badramattack/spd-programmer/kicad/spd-programmer-jlcpcb-bom.csv

Comment | Designator | Footprint | JLCPCB Part #
1uF | C1,C2,C3,C4,C5,C6 | Capacitor_SMD:C_0603_1608Metric | C15849
100nF | C7 | Capacitor_SMD:C_0603_1608Metric | C14663
10uF 25V | C8,C9,C10,C11 | Capacitor_SMD:C_0805_2012Metric | C15850
SS14 | D1 | Diode_SMD:D_SMA | C2480
Red LED 0805 | D2,D6 | LED_SMD:LED_0805_2012Metric | C84256
Green LED 0805 | D3,D7,D8,D9,D10 | LED_SMD:LED_0805_2012Metric | C2297
Yellow LED 0805 | D4,D5 | LED_SMD:LED_0805_2012Metric | C2296
AO3400A | Q1 | Package_TO_SOT_SMD:SOT-23 | C20917
150k | R1 | Resistor_SMD:R_0603_1608Metric | C22807
2.2k | R2,R5 | Resistor_SMD:R_0603_1608Metric | C4190
100k | R3,R6,R8,R9 | Resistor_SMD:R_0603_1608Metric | C25803
220k | R4 | Resistor_SMD:R_0603_1608Metric | C22961
10k | R7,R14,R19,R21,R23,R24,R25,R27 | Resistor_SMD:R_0603_1608Metric | C25804
47 | R10 | Resistor_SMD:R_0805_2012Metric | C17714
4.7k | R11,R12,R13,R16 | Resistor_SMD:R_0603_1608Metric | C23162
10 | R15 | Resistor_SMD:R_0603_1608Metric | C22859
1.2k | R17 | Resistor_SMD:R_0603_1608Metric | C22765
1k | R18,R26 | Resistor_SMD:R_0603_1608Metric | C21190
150 | R20 | Resistor_SMD:R_0603_1608Metric | C22808
3.3k | R22 | Resistor_SMD:R_0603_1608Metric | C22978
220 | R28 | Resistor_SMD:R_0603_1608Metric | C22962
2.7k | R32,R33,R34,R35 | Resistor_SMD:R_0603_1608Metric | C13167
680 | R29,R30,R31 | Resistor_SMD:R_0603_1608Metric | C23228
MST-22D18G2-3J SPDT slide switch | SW1,SW4 | spd:SW_SPDT_CK_JS102011SAQN_SCQN_ShouHan_MST-22D18G2 | C2875122
TS-1187A tactile switch | SW2,SW3 | Button_Switch_SMD:SW_Push_1P1T_XKB_TS-1187A | C318884
TPS2553DBVR | U1,U2 | Package_TO_SOT_SMD:SOT-23-6 | C55266
XC6206P252MR | U3 | Package_TO_SOT_SMD:SOT-23-3 | C15906
SN74LVC2G66DCUR | U4 | Package_SO:VSSOP-8_2.3x2mm_P0.5mm | C181970
LM2665M6X/NOPB | U5 | Package_TO_SOT_SMD:SOT-23-6 | C201725
LP2951ACDR2G | U6 | Package_SO:SOIC-8_3.9x4.9mm_P1.27mm | C232432
