badramattack/spd-programmer/kicad/spd-programmer-schematic.pdf

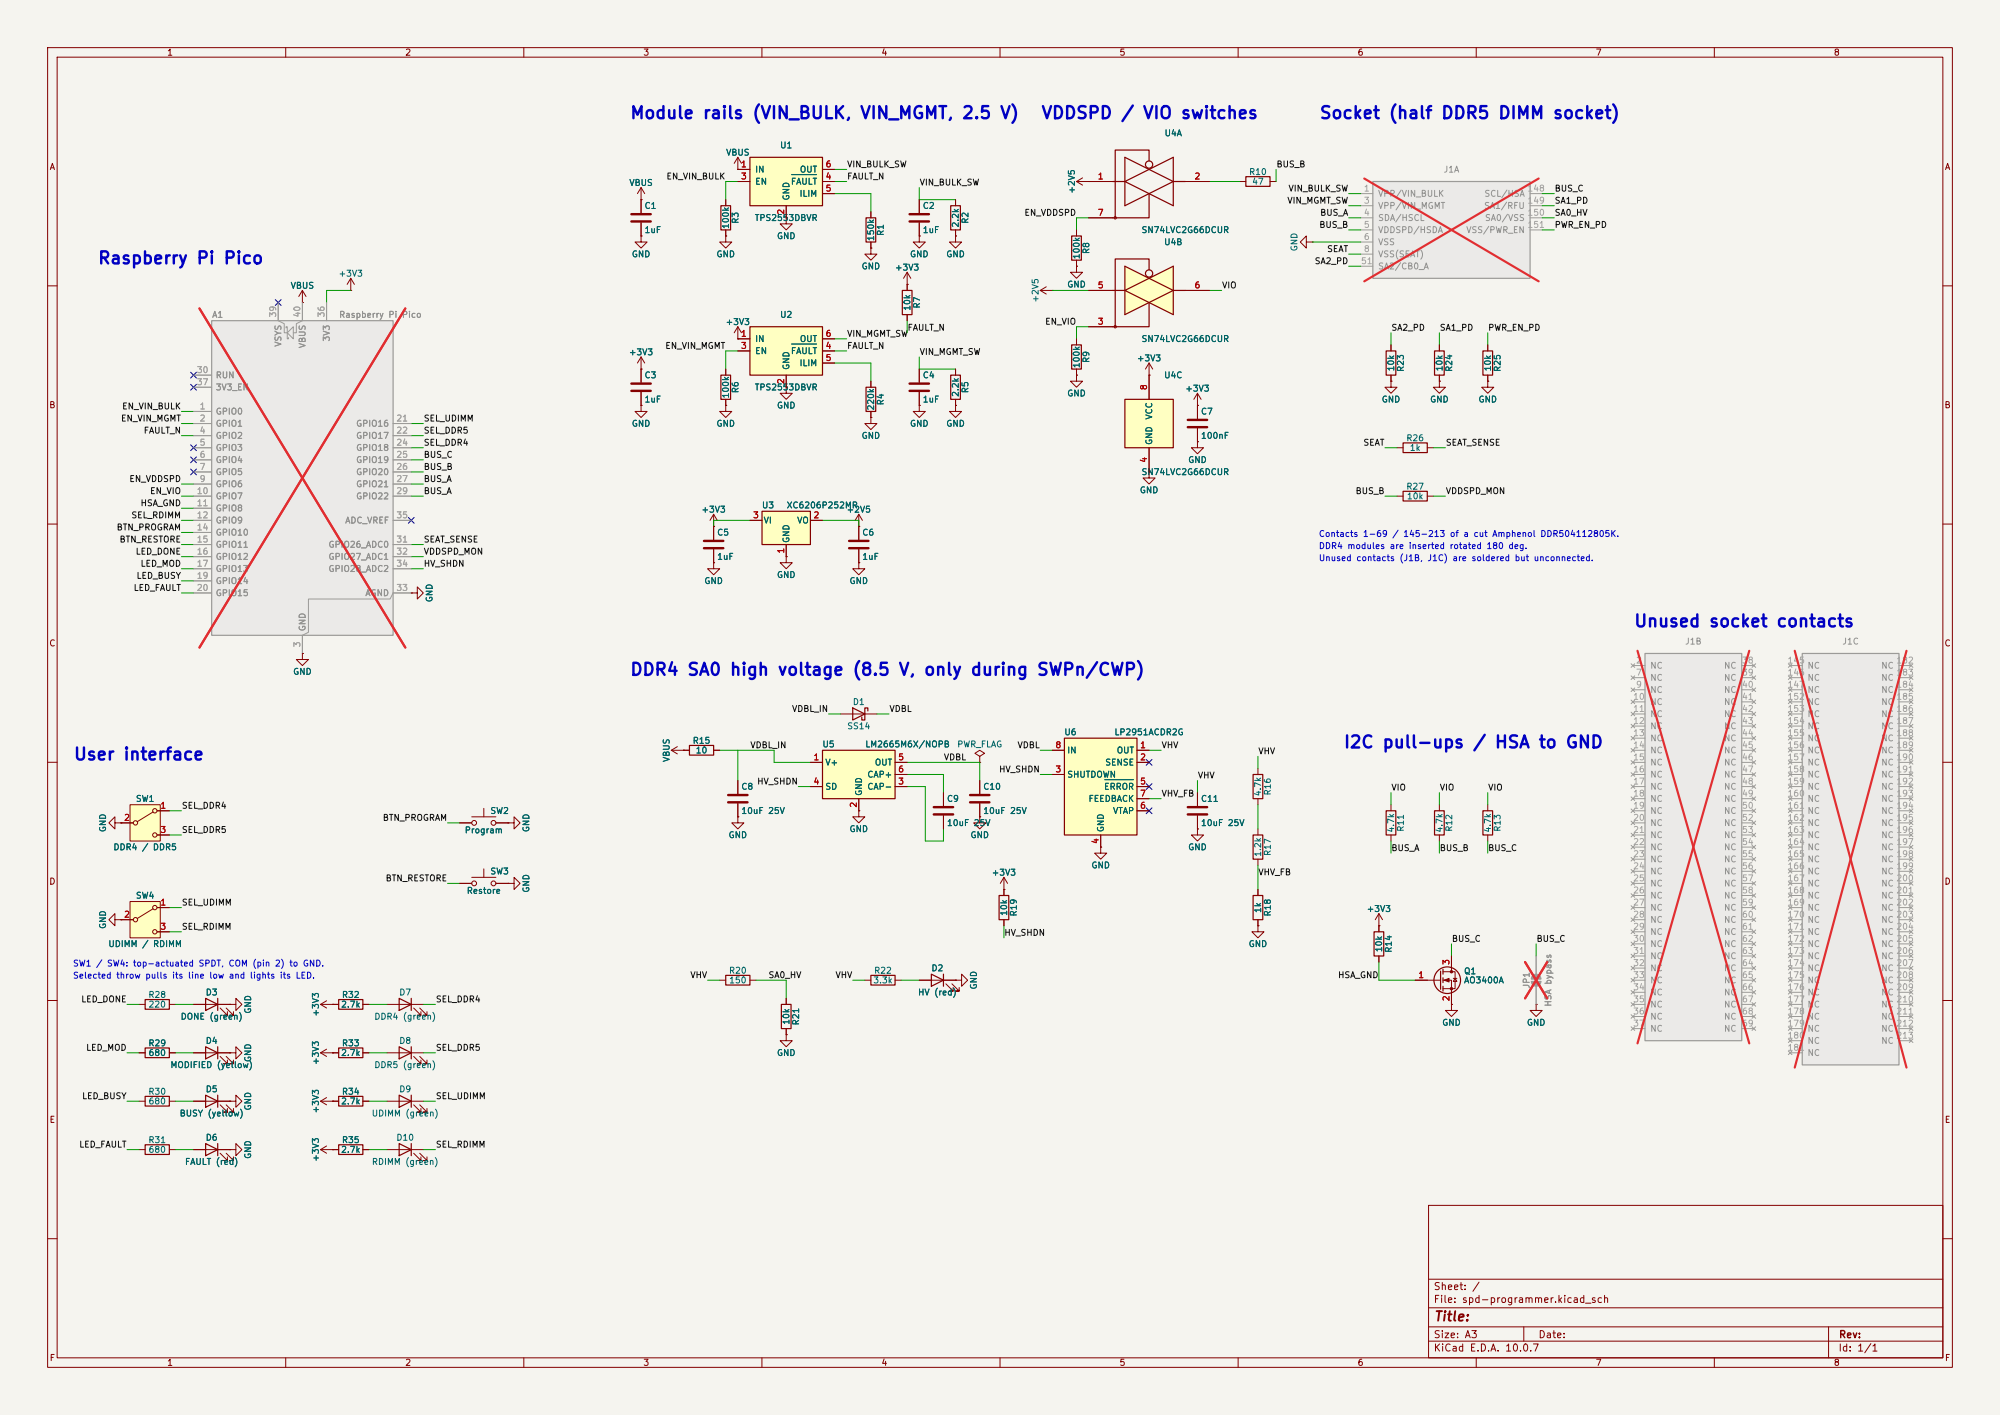
[picture p2: page 1]

Unused contacts (J1B, J1C) are soldered but unconnected. Module rails (VIN_BULK, VIN_MGMT, 2.5 V) VDDSPD / VIO switches

Socket (half DDR5 DIMM socket)

DDR4 modules are inserted rotated 180 deg. Contacts 1-69 / 145-213 of a cut Amphenol DDR504112805K. User interface

DDR4 SA0 high voltage (8.5 V, only during SWPn/CWP)

Size: A3 | Rev: | F Date:
KiCad E.D.A. 10.0.7 | Id: 1/1
