badramattack/spd-programmer/kicad/spd-programmer.kicad_pcb

## KiCad design kicad/spd-programmer.kicad_pcb (2026-11-04)

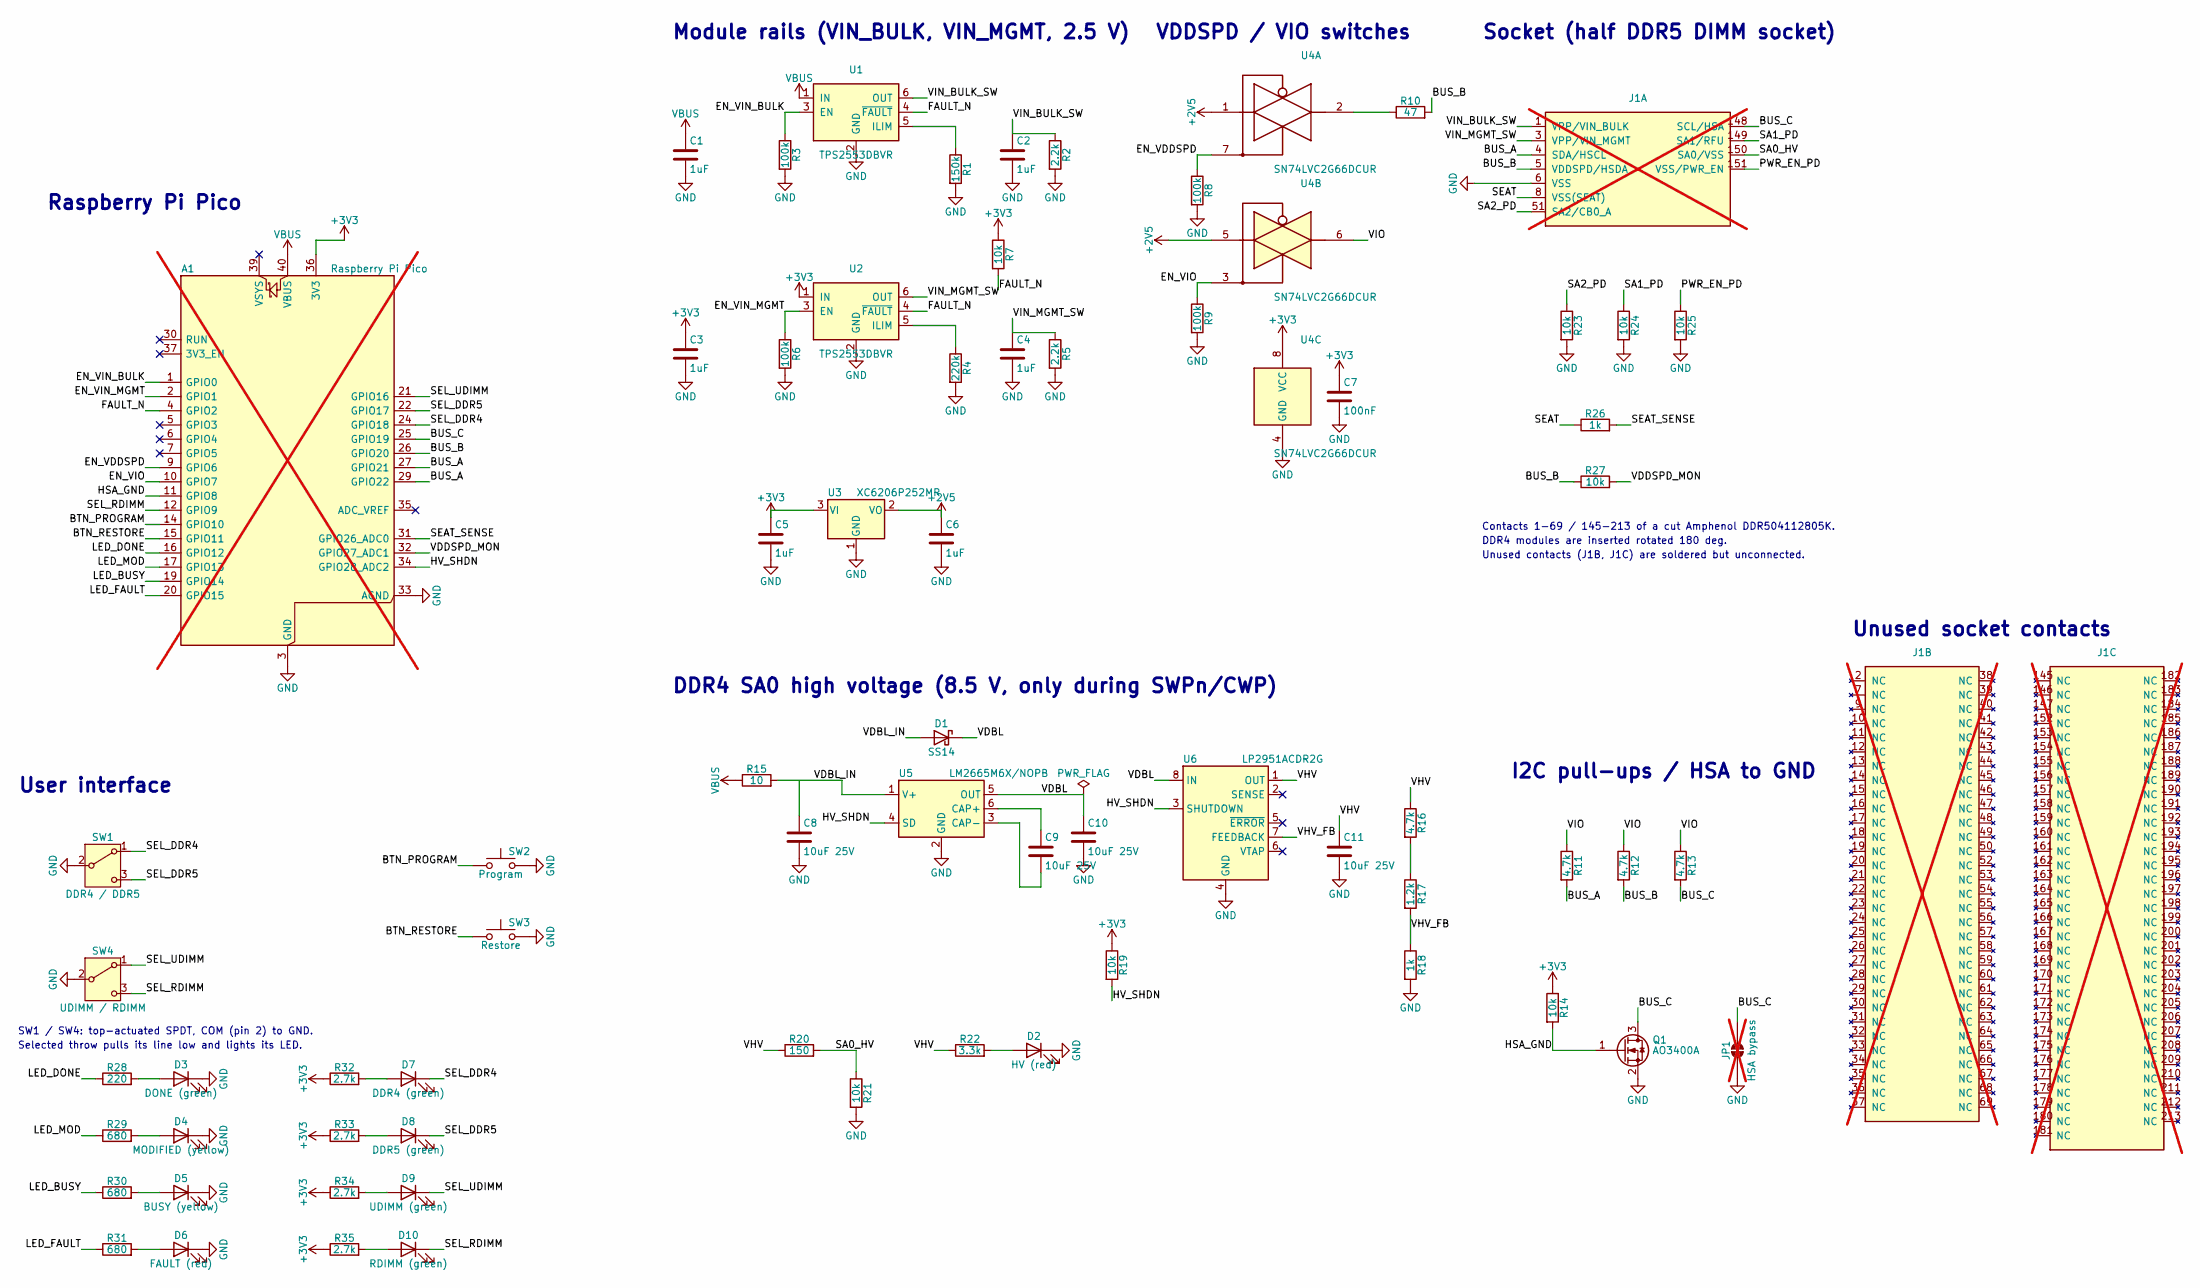
[picture p3: schematic spd-programmer.kicad_sch]

Parts:
A1: Raspberry Pi Pico; RaspberryPi_Pico_SMD_HandSolder; MPN Raspberry Pi Pico (RP2040); not fitted
C1, C2, C3, C4, C5, C6: 1uF; C_0603_1608Metric; MPN 1uF X5R 0603; LCSC C15849
C7: 100nF; C_0603_1608Metric; MPN 100nF X7R 0603; LCSC C14663
C8, C9, C10, C11: 10uF 25V; C_0805_2012Metric; MPN 10uF 25V X5R 0805; LCSC C15850
D1: SS14; D_SMA; MPN SS14 (MDD); Farnell_MPN SS14 (Multicomp Pro)
D2: HV (red); LED_0805_2012Metric; MPN NCD0805R1; Farnell_MPN TBD (0805 red)
D3: DONE (green); LED_0805_2012Metric; MPN KT-0805G; Farnell_MPN MP008291
D4: MODIFIED (yellow); LED_0805_2012Metric; MPN KT-0805Y; Farnell_MPN TBD (0805 yellow)
D5: BUSY (yellow); LED_0805_2012Metric; MPN KT-0805Y; Farnell_MPN TBD (0805 yellow)
D6: FAULT (red); LED_0805_2012Metric; MPN NCD0805R1; Farnell_MPN TBD (0805 red)
D7: DDR4 (green); LED_0805_2012Metric; MPN KT-0805G; Farnell_MPN MP008291
D8: DDR5 (green); LED_0805_2012Metric; MPN KT-0805G; Farnell_MPN MP008291
D9: UDIMM (green); LED_0805_2012Metric; MPN KT-0805G; Farnell_MPN MP008291
D10: RDIMM (green); LED_0805_2012Metric; MPN KT-0805G; Farnell_MPN MP008291
J1: DDR504112805K_half; DDR5_DIMM_HalfSocket_P0.85mm; MPN Amphenol DDR504112805K (half); not fitted
JP1: HSA bypass; SolderJumper-2_P1.3mm_Open_TrianglePad1.0x1.5mm; MPN Solder jumper; not fitted
Q1: AO3400A; SOT-23; MPN AO3400A; Farnell_MPN XP2344GN
R1: 150k; R_0603_1608Metric; MPN 150k 1% 0603; LCSC C22807
R2, R5: 2.2k; R_0603_1608Metric; MPN 2.2k 1% 0603; LCSC C4190
R3, R6, R8, R9: 100k; R_0603_1608Metric; MPN 100k 1% 0603; LCSC C25803
R4: 220k; R_0603_1608Metric; MPN 220k 1% 0603; LCSC C22961
R7, R14, R19, R21, R23, R24, R25, R27: 10k; R_0603_1608Metric; MPN 10k 1% 0603; LCSC C25804
R10: 47; R_0805_2012Metric; MPN 47 1% 0805; LCSC C17714
R11, R12, R13, R16: 4.7k; R_0603_1608Metric; MPN 4.7k 1% 0603; LCSC C23162
R15: 10; R_0603_1608Metric; MPN 10 1% 0603; LCSC C22859
R17: 1.2k; R_0603_1608Metric; MPN 1.2k 1% 0603; LCSC C22765
R18, R26: 1k; R_0603_1608Metric; MPN 1k 1% 0603; LCSC C21190
R20: 150; R_0603_1608Metric; MPN 150 1% 0603; LCSC C22808
R22: 3.3k; R_0603_1608Metric; MPN 3.3k 1% 0603; LCSC C22978
R28: 220; R_0603_1608Metric; MPN 220 1% 0603; LCSC C22962
R29, R30, R31: 680; R_0603_1608Metric; MPN 680 1% 0603; LCSC C23228
R32, R33, R34, R35: 2.7k; R_0603_1608Metric; MPN 2.7k 1% 0603; LCSC C13167
SW1: DDR4 / DDR5; SW_SPDT_CK_JS102011SAQN_SCQN_ShouHan_MST-22D18G2; MPN SHOU HAN MST-22D18G2-3J; LCSC C2875122
SW2: Program; SW_Push_1P1T_XKB_TS-1187A; MPN TS-1187A-B-A-B; Farnell_MPN TM-533I-Q-T/R
SW3: Restore; SW_Push_1P1T_XKB_TS-1187A; MPN TS-1187A-B-A-B; Farnell_MPN TM-533I-Q-T/R
SW4: UDIMM / RDIMM; SW_SPDT_CK_JS102011SAQN_SCQN_ShouHan_MST-22D18G2; MPN SHOU HAN MST-22D18G2-3J; LCSC C2875122
U1, U2: TPS2553DBVR; SOT-23-6; MPN TPS2553DBVR; LCSC C55266
U3: XC6206P252MR; SOT-23-3; MPN XC6206P252MR; Farnell_MPN MCP1700T-2502E/TT
U4: SN74LVC2G66DCUR; VSSOP-8_2.3x2mm_P0.5mm; MPN SN74LVC2G66DCUR; Farnell_MPN 74LVC2G66DC,125
U5: LM2665M6X/NOPB; SOT-23-6; MPN LM2665M6X/NOPB; Farnell_MPN LM2665M6/NOPB
U6: LP2951ACDR2G; SOIC-8_3.9x4.9mm_P1.27mm; MPN LP2951ACDR2G; Farnell_MPN NCV2951ACDR2G

Connections:
+2V5: C6.1, U3.2 (VO), U4.1, U4.5
+3V3: A1.36 (3V3), C3.1, C5.1, C7.1, R7.1, R14.1, R19.1, R32.1, R33.1, R34.1, R35.1, U2.1 (IN), U3.3 (VI), U4.8 (VCC)
/BTN_PROGRAM: A1.14 (GPIO10), SW2.1
/BTN_RESTORE: A1.15 (GPIO11), SW3.1
/BUS_A: A1.27 (GPIO21), A1.29 (GPIO22), J1.4 (SDA/HSCL), R11.2
/BUS_B: A1.26 (GPIO20), J1.5 (VDDSPD/HSDA), R10.2, R12.2, R27.1
/BUS_C: A1.25 (GPIO19), J1.148 (SCL/HSA), JP1.2 (B), Q1.3 (D), R13.2
/EN_VDDSPD: A1.9 (GPIO6), R8.1, U4.7
/EN_VIN_BULK: A1.1 (GPIO0), R3.1, U1.3 (EN)
/EN_VIN_MGMT: A1.2 (GPIO1), R6.1, U2.3 (EN)
/EN_VIO: A1.10 (GPIO7), R9.1, U4.3
/FAULT_N: A1.4 (GPIO2), R7.2, U1.4 (~FAULT), U2.4 (~FAULT)
/HSA_GND: A1.11 (GPIO8), Q1.1 (G), R14.2
/HV_SHDN: A1.34 (GPIO28_ADC2), R19.2, U5.4 (SD), U6.3 (SHUTDOWN)
/LED_BUSY: A1.19 (GPIO14), R30.1
/LED_DONE: A1.16 (GPIO12), R28.1
/LED_FAULT: A1.20 (GPIO15), R31.1
/LED_MOD: A1.17 (GPIO13), R29.1
/PWR_EN_PD: J1.151 (VSS/PWR_EN), R25.1
/SA0_HV: J1.150 (SA0/VSS), R20.2, R21.1
/SA1_PD: J1.149 (SA1/RFU), R24.1
/SA2_PD: J1.51 (SA2/CB0_A), R23.1
/SEAT: J1.8 (VSS(SEAT)), R26.1
/SEAT_SENSE: A1.31 (GPIO26_ADC0), R26.2
/SEL_DDR4: A1.24 (GPIO18), D7.1 (K), SW1.1 (A)
/SEL_DDR5: A1.22 (GPIO17), D8.1 (K), SW1.3 (C)
/SEL_RDIMM: A1.12 (GPIO9), D10.1 (K), SW4.3 (C)
/SEL_UDIMM: A1.21 (GPIO16), D9.1 (K), SW4.1 (A)
/VDBL: C10.1, D1.1 (K), U5.5 (OUT), U6.8 (IN)
/VDBL_IN: C8.1, D1.2 (A), R15.2, U5.1 (V+)
/VDDSPD_MON: A1.32 (GPIO27_ADC1), R27.2
/VHV: C11.1, R16.1, R20.1, R22.1, U6.1 (OUT)
/VHV_FB: R17.2, R18.1, U6.7 (FEEDBACK)
/VIN_BULK_SW: C2.1, J1.1 (VPP/VIN_BULK), R2.1, U1.6 (OUT)
/VIN_MGMT_SW: C4.1, J1.3 (VPP/VIN_MGMT), R5.1, U2.6 (OUT)
/VIO: R11.1, R12.1, R13.1, U4.6
GND: A1.3 (GND), A1.8 (GND), A1.13 (GND), A1.18 (GND), A1.23 (GND), A1.28 (GND), A1.33 (AGND), A1.38 (GND), C1.2, C2.2, C3.2, C4.2, C5.2, C6.2, C7.2, C8.2, C10.2, C11.2, D2.1 (K), D3.1 (K), D4.1 (K), D5.1 (K), D6.1 (K), J1.6 (VSS), JP1.1 (A), Q1.2 (S), R1.2, R2.2, R3.2, R4.2, R5.2, R6.2, R8.2, R9.2, R18.2, R21.2, R23.2, R24.2, R25.2, SW1.2 (B), SW2.2, SW3.2, SW4.2 (B), U1.2 (GND), U2.2 (GND), U3.1 (GND), U4.4 (GND), U5.2 (GND), U6.4 (GND)
unnamed: D2.2 (A), R22.2
unnamed: D3.2 (A), R28.2
unnamed: D4.2 (A), R29.2
unnamed: D5.2 (A), R30.2
unnamed: D6.2 (A), R31.2
unnamed: D7.2 (A), R32.2
unnamed: D8.2 (A), R33.2
unnamed: D9.2 (A), R34.2
unnamed: D10.2 (A), R35.2
unnamed: R10.1, U4.2
unnamed: R16.2, R17.1
unnamed: R1.1, U1.5 (ILIM)
unnamed: R4.1, U2.5 (ILIM)
unnamed: C9.1, U5.6 (CAP+)
unnamed: C9.2, U5.3 (CAP-)
VBUS: A1.40 (VBUS), C1.1, R15.1, U1.1 (IN)

Notes on the sheet:
User interface
DDR4 SA0 high voltage (8.5 V, only during SWPn/CWP)
Unused socket contacts
SW1 / SW4: top-actuated SPDT, COM (pin 2) to GND.
Unused contacts (J1B, J1C) are soldered but unconnected.
Module rails (VIN_BULK, VIN_MGMT, 2.5 V)
Socket (half DDR5 DIMM socket)
VDDSPD / VIO switches
I2C pull-ups / HSA to GND
Raspberry Pi Pico
DDR4 modules are inserted rotated 180 deg.
Selected throw pulls its line low and lights its LED.
Contacts 1-69 / 145-213 of a cut Amphenol DDR504112805K.

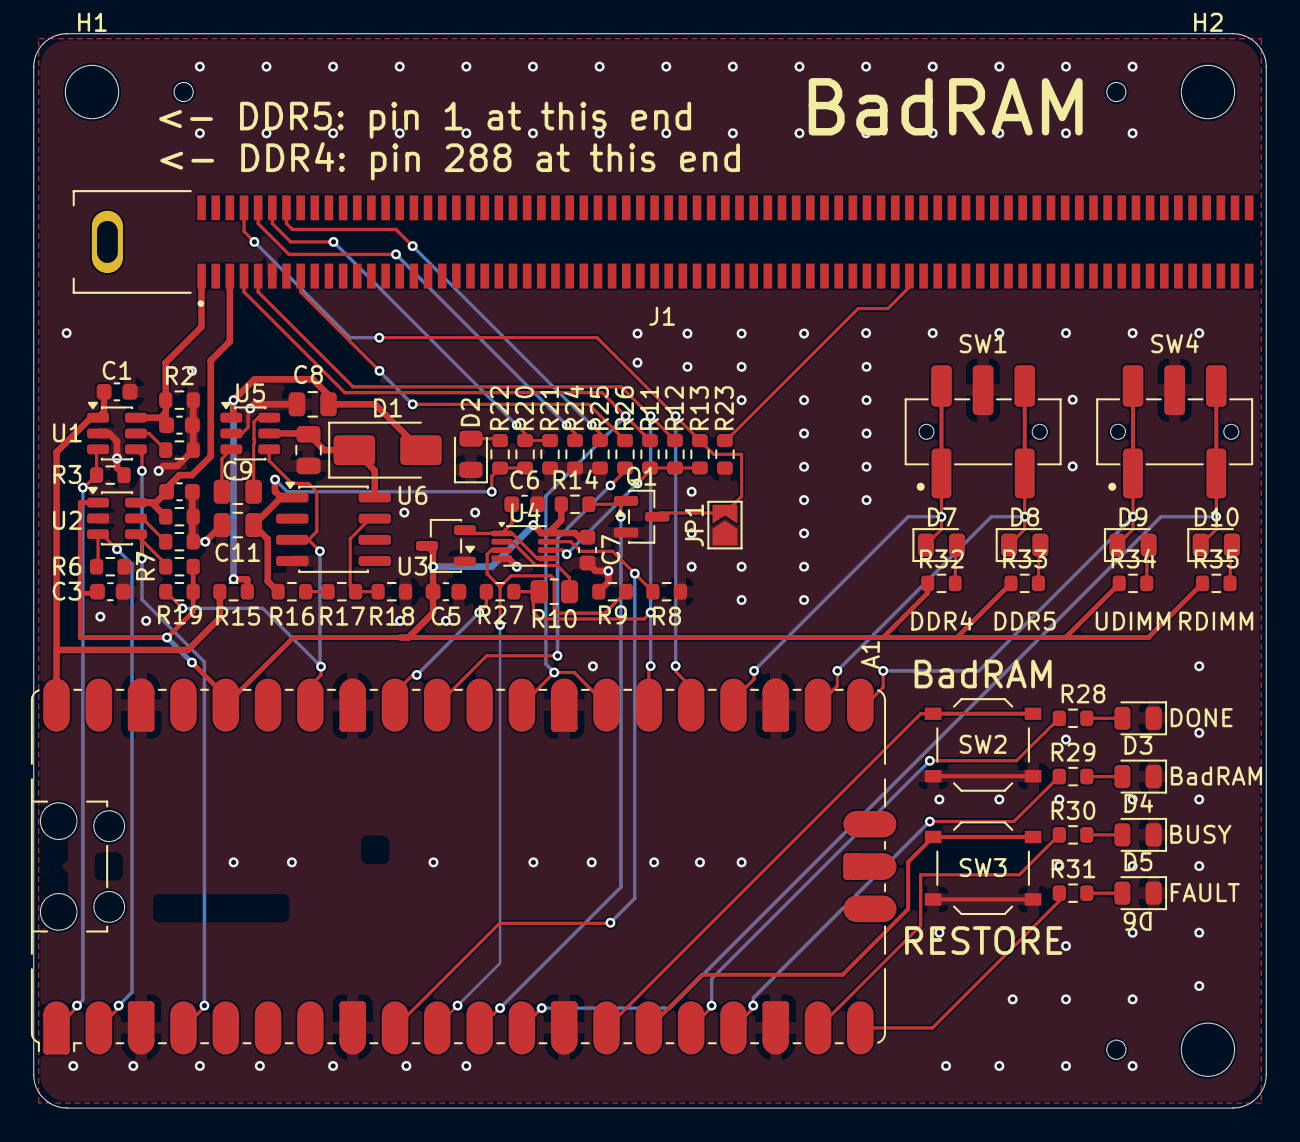
[picture p4: board spd-programmer.kicad_pcb from above]

Board: 2 copper layers, 74.0 x 64.5 mm, 74 parts (1 on the bottom side), 53 nets.

Other parts of the board:
H1, H2, H3: MountingHole_3.2mm_M3
LOGO1: Logos
